qwerty-dvorak/crashguard-iot/README.md

# CrashGuard: motorcycle crash detection and IoT alerts

The complete, self-contained research artifact is in [paper/](paper/).

- [**Read the research paper (PDF)**](paper/main_manuscript.pdf)
- [**LaTeX manuscript**](paper/main_manuscript.tex) and [references](paper/references.bib)
- [ESP32 firmware and circuit](paper/wokwi/)
- [Simulation and evaluation scripts](paper/analysis/)
- [Experimental results and logs](paper/results/)
- [Dataset provenance and source attribution](paper/data/README.md)

### Repository Manuscripts
- **`paper/main_manuscript.tex` (and `.pdf`)**: The **primary, complete research paper** containing the full rigid-body kinematic simulation, Boubezoul et al. (2013) baseline comparison, paired McNemar statistical hypothesis tests, parametric sensitivity analysis, and virtual firmware defect discovery.
- **`review3/review3_report.tex` (and `.pdf`)**: Milestone report submitted for Review 3 (archived).
- **`legacy_v1_report.tex` (and `.pdf`)**: Original project report draft (archived).

## Reproduce the paper

```sh
git clone https://github.com/qwerty-dvorak/crashguard-iot.git
cd crashguard-iot/paper
python3 -m pip install -r analysis/requirements.txt
sh reproduce.sh
```

A C++17 compiler and LaTeX installation with latexmk are required. The `paper/` directory contains all project inputs needed by the build; its pipeline verifies and extracts the bundled public PTW supplement, generates both simulated motion datasets, runs the firmware scenarios, and compiles the PDF. See [paper/README.md](paper/README.md) for details.

The paper evaluates 945 simulated events, 14 firmware scenarios, 39 DC interface combinations, nine battery-discharge cases, and public motorcycle signal gates. The source code and experimental records distinguish detector performance, local warning behaviour, and the simulated event-service boundary.
