qwerty-dvorak/crashguard-iot/review3/Assessment-6 D2 .md

**School of Computer Science and Engineering (SCOPE)**

**Course code and Name: BCSE312P - Programming for IoT Boards Lab**

**Class Number:  VL2026270103137**

**Name of the Faculty: Syamasudha Veeragandham 22727**

# **Date: 4/09/2026 \[11:40 AM to 1:20 PM\]  	Slot: L29+L30       **  

# **Assessment-6**  
**Maximum Marks: 10**

# **Note: Include the suggestions given in the lab 5 also.**  

# **Problem Statement **–IoT Integration, Testing & Performance Evaluation

**Objective:** Validate the developed prototype under different operating conditions and demonstrate its IoT capabilities.

### Students should complete:

1. **Test Cases** 

   - Minimum **5 test cases**. 

   - Include normal, boundary and abnormal conditions. 

2. **Test Results** 

   - Record actual system output. 

   - Compare expected and actual results. 

   - Provide screenshots/logs wherever appropriate. 

3. **Performance Comparison** 

   - Compare **baseline vs proposed method**. 

   - Select suitable metrics: 

     - Accuracy 

     - Response time 

     - Detection rate 

     - False-positive rate 

     - Energy consumption 

     - Network latency 

     - Resource utilization 

     - Prediction accuracy 

4. **IoT Communication Demonstration**

   - Demonstrate communication between: 

**Sensor → IoT Controller → Network → Cloud/Server → User**

   - Suitable technologies: 

     - MQTT 

     - HTTP 

     - Wi-Fi 

     - Firebase 

     - ThingSpeak 

     - Blynk 

     - Node-RED 

5. **Dashboard / User Interface** 

   - Display real-time sensor values. 

   - Show device/actuator status. 

   - Display alerts. 

   - Show graphs or historical data where applicable. 

6. **Fault-Handling Mechanism** 

   - Demonstrate at least **2 fault conditions**. 

   - Examples: 

     - Sensor failure 

     - Invalid sensor value 

     - Network failure 

     - Actuator failure 

     - Power failure 

   - Show how the system detects and handles the fault. 

7. **Expected vs Actual Results** 

   - Prepare a comparison table. 

   - Explain deviations between expected and actual performance. 

8. **Future Enhancement** 

   - Identify at least 3 improvements. 

   - Examples: 

     - AI/ML integration 

     - Edge computing 

     - Mobile application 

     - More sensors 

     - Improved prediction 

     - Security enhancement 

     - Energy optimization 

     - Real-world hardware deployment
