qwerty-dvorak/crashguard-iot/review3/review3_report.pdf

# CrashGuard: IoT Integration, Testing, and Performance Evaluation

### Crash Detection and Rider-Cancellable Emergency Alert System

### Adheesh Garg (23BCT0122) Aastha Gupta (23BCT0082)

### Ayan Gatani (23BCT0059)

### Programming for IoT Boards Lab (BCSE312P)

Class VL2026270103137 | Faculty: Syamasudha Veeragandham (22727)
Assessment 6, Review 3 | 4 September 2026

Abstract

This report evaluates CrashGuard, an ESP32 and MPU-6050 prototype that detects fall-like motorcycle motion, activates a local LED and piezo alarm, gives the rider 15 seconds to cancel, and then attempts a Blynk IoT event. Because physical hardware is unavailable, the evidence combines exact-code native replay, 675 deterministic six-axis events, four public powered-two-wheeler falls, seven public critical manoeuvres, target compilation, and a fresh three-scenario Wokwi virtual-hardware run. Ten normal, boundary, abnormal, and fault-oriented cases are reported. CrashGuard obtains 94.7% simulated event accuracy, 76.0% sensitivity, 100.0% observed specificity, and a 2.31 s median confirmation delay. An acceleration-only comparison is more sensitive (89.3%) but raises false alarms on 55.0% of simulated non-crash events. The report also defines the Blynk event, dashboard mapping, communication chain, fault responses, deviations, and future validation plan. No physical crash accuracy, phone-notification receipt, network latency, or measured battery life is claimed.

## Contents

1 Assessment objective and coverage | 3
2 System under test | 3
3 Evidence, data, and reproducibility | 4
4 Test plan and acceptance criteria | 5
5 Detailed test results | 7
6 Performance comparison | 8
7 IoT communication demonstration | 9
8 Dashboard and user interface | 10
9 Fault handling | 12
10 Expected versus actual results and deviations | 13
11 Resource, energy, and network evaluation | 13
12 Future enhancements | 14
13 Limitations, safety, and conclusion | 14

## 1 Assessment objective and coverage

Assessment 6 requires integration, testing, performance evaluation, IoT communication, a dashboard, fault handling, expected-versus-actual analysis, and future enhancements. Table 1 maps each requirement to the evidence in this report.

Table 1: Assessment requirement coverage.

Requirement | Evidence | Section
At least five tests | Ten normal, boundary, abnormal, and fault-oriented cases | 4–5
Expected versus actual | Acceptance criteria, actual output, status, and de- viation table | 5, 10
Performance comparison | Accuracy, sensitivity, false-positive rate, F1, delay, and resources | 6
IoT communication | Sensor-to-controller-to-network-to-Blynk-to-user chain | 7
Dashboard / UI | Reproducible replay dashboard and Blynk widget specification | 8
Two fault conditions | Sensor/I²C and Wi-Fi/Blynk failure behavior | 9
Future enhancements | Prioritized hardware, communication, security, and model work | 12

The previous review’s suggestions are retained: CrashGuard is treated as one system rather than a sequence of named versions; its thresholds are compared with public motorcycle data; the supplied human-fall paper is audited rather than copied; the firmware and replay share decision logic; and Wokwi and cloud claims are bounded to what was actually tested.

## 2 System under test

### 2.1 Purpose and hardware

CrashGuard is mounted on the motorcycle handlebar. Its MPU-6050 supplies three-axis acceleration and angular rate at 100 Hz. The ESP32 calculates acceleration magnitude, angular-rate magnitude, and tilt relative to the stationary startup gravity vector. GPIO26 drives the warning LED; GPIO25 drives a physical 5 V passive piezo through a transistor; GPIO27 reads the active-low cancel button; and GPIO34 monitors the divided battery voltage. The MPU-6050 is configured for ±16g and ±2000◦/s to reduce immediate saturation under rapid motion [1]. GPIO34 is an ADC1 input and remains usable while Wi-Fi is active [2].

Table 2: Interfaces of the evaluated prototype.

Subsystem | Interface | Evaluated role
MPU-6050 | I²C, GPIO21/22 | Six-axis source at 100 Hz
Local alarm | GPIO26 LED, GPIO25 piezo | Immediate rider-visible/audible warning
Rider input | GPIO27, internal pull- up | Cancels pending cloud alert
Battery sense | GPIO34 through 1:2 divider | Startup voltage observation
Network | ESP32 Wi-Fi station | Phone hotspot or Wokwi-GUEST
Cloud/user | Blynk IoT SSL client | Event timeline and notification attempt

### 2.2 CrashGuard decision sequence

The detector does not equate a single shock with a crash. It first requires one second of ride-like activity and remembers it for five seconds. A candidate then begins when acceleration magnitude A satisfies A ≥ 2.0g or A ≤ 0.35g. Angular motion Ω ≥ 90◦/s must occur within a 750 ms correlation interval, in either order. Finally, tilt must reach 55◦ while 0.70g ≤ A ≤ 1.30g and Ω ≤ 30◦/s continuously for two seconds. A candidate that does not establish final rest within six seconds is rejected.

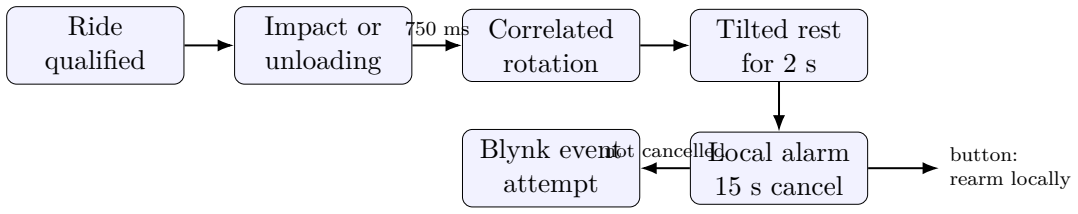
[picture p7: figure]
Ride qualified; Impact or unloading; Correlated rotation; Tilted rest for 2 s; Local alarm 15 s cancel; Blynk event attempt; not cancelled; button:; rearm locally

Figure 1: State sequence exercised by replay and virtual-hardware tests.

## 3 Evidence, data, and reproducibility

### 3.1 Evidence levels

Four evidence levels prevent unlike results from being merged:
1. Exact-code native replay: the same portable C++ detector used by the ESP32 processes complete event streams.
2. Virtual hardware: Wokwi exercises the ESP32 binary, virtual MPU-6050, button, LED, piezo, and serial markers.
3. Target compilation: Arduino compilation verifies ESP32 and Blynk library compatibility and reports static resource use.
4. External audit: public powered-two-wheeler recordings test feature-scale portability but cannot reproduce the complete detector because a reliable mounting-specific gravity reference is absent.
No level represents a physical road test. The Wokwi scenario API can set virtual MPU values and assert serial or pin output, making it useful for repeatable control-flow tests rather than vehicle mechanics [3].

### 3.2 Deterministic and public data

The deterministic dataset contains 675 ten-second events at 100 Hz, or 675,000 six-axis samples. A fixed seed (20260828) generates 75 examples of each class: normal riding, pothole, speed breaker, hard brake, sharp turn, parked tip-over, impact with recovery, low-side crash, and high-side crash. Only the final two classes are labelled positive. The generator uses attitude trajectories, body-frame gravity, linear pulses, derivative-based angular rates, bias, noise, and sensor-range clipping. It is repeatable but remains a model created in the same project as the detector.
The independent powered-two-wheeler archive contributes four controlled falls and seven critical manoeuvres [4, 5]. All four fall windows cross CrashGuard’s acceleration and rotation gates after anti-aliased resampling to 100 Hz; none reaches the stricter 4 g and 200 ◦/s comparison thresholds. This supports scale selection, not a complete external accuracy result.

### 3.3 Reproduction commands on Void Linux

The commands below rebuild the prior dataset, replay results, figures, and report. They do not require Wokwi cloud minutes.

sudo xbps-install -S base-devel python3 python3-pip texlive \
texlive-most texlive-latexmk poppler-utils
cd /path/to/crashguard-iot
python3 -m venv .venv
. .venv/bin/activate
python -m pip install -r analysis/requirements.txt sh data/download_datasets.sh ./analysis/run_all.sh
sha256sum -c data/manifest.sha256
cd review3
python3 make_dashboard.py
latexmk -pdf report.tex

## 4 Test plan and acceptance criteria

The test strategy covers normal operation, threshold boundaries, abnormal but non-crash motion, user cancellation, and unavailable dependencies. A test is Pass only if its observable result meets the predeclared criterion. Partial records a real limitation rather than silently changing the criterion after observing the output.

Table 3: Normal, boundary, abnormal, and fault-oriented test matrix.

ID | Condition | Class | Expected output / acceptance | Actual evidence | Status
TC-01 Normal riding | Normal | No candidate, crash, or alert in
| | | all 75 events | CrashGuard predictions: 0/75 positive | Pass
TC-02 Pothole pulse | Abnormal
| | non-crash | Candidate rejected; LED re-
| | mains low | Replay: 0/75 alerts; Wokwi: CANDIDATE_REJECTED, GPIO26 low | Pass
TC-03 Speed breaker | Boundary non-crash | Reject vertical shock without fall sequence | Replay: 0/75 alerts; acceleration-only method flags 70/75 | Pass
TC-04 High-side crash | Positive | Confirm all clear high-energy ex-
| | amples | Replay: 75/75 detected; fresh Wokwi run reaches local alarm and deadline | Pass
TC-05 Low-side crash | Boundary pos-
itive | Detect every lower-energy crash Replay: 39/75 detected; 36 false negatives | Partial
TC-06 Parked tip-over | Abnormal non-crash | Suppress alert without recent ride activity | Replay: 0/75 alerts; acceleration-only method flags 70/75 | Pass

TC-07 Impact then recov-

ery | Abnormal non-crash | Reject because stable tilted rest is absent | Replay: 0/75 alerts; acceleration-only method flags 74/75 | Pass
TC-08 Rider cancellation User | input
| boundary | Stop alarm and suppress later alert deadline | Fresh Wokwi run: ALERT_CANCELLED; GPIO26 low after 16 s guard | Pass
TC-09 Network/Blynk unavailable | Fault | Preserve detection/local alarm and report skipped event hon- estly | Credential-free target build passes; explicit unavail- able result paths exist; current cloud receipt unmea-
sured | Partial
TC-10 MPU-6050 | un-
available/read
error
Fault | Safe stop at boot or skip corrupt
cycle without false alert

Firmware emits fatal boot or read warning and omits detector update; hardware/Wokwi disconnect not executed

Partial

6

## 5 Detailed test results

### 5.1 Normal and abnormal non-crash conditions

CrashGuard reports no positive decision in any of the 75 normal-riding, 75 pothole, 75 speed-breaker, 75 hard-brake, 75 sharp-turn, 75 parked-tip-over, or 75 impact-recovery events. These 525 results explain the observed 100% specificity. The mechanisms differ: potholes and speed breakers lack the correlated fall sequence; parked tip-overs lack recent ride activity; impact with recovery lacks sustained tilted rest; and hard braking or sharp turns do not satisfy the entire chain.
The acceleration-only comparison highlights why these checks matter. It marks 75/75 potholes, 70/75 speed breakers, 70/75 parked tip-overs, and 74/75 impact-recovery events as crashes. Thus, its 289 false positives are not scattered numerical accidents: they concentrate in plausible riding events that CrashGuard was designed to reject.

### 5.2 Positive and boundary crash conditions

All 75 high-side simulated crashes are detected. Only 39 of 75 low-side cases are detected, making low-side motion the principal boundary failure. The missed examples are lower-energy and sometimes fail to combine the configured acceleration gate, 90 ◦/s rotation, and stable-rest evidence inside the allowed intervals. Lowering a single threshold would recover some cases but would also be unsafe to justify from co-developed synthetic data.

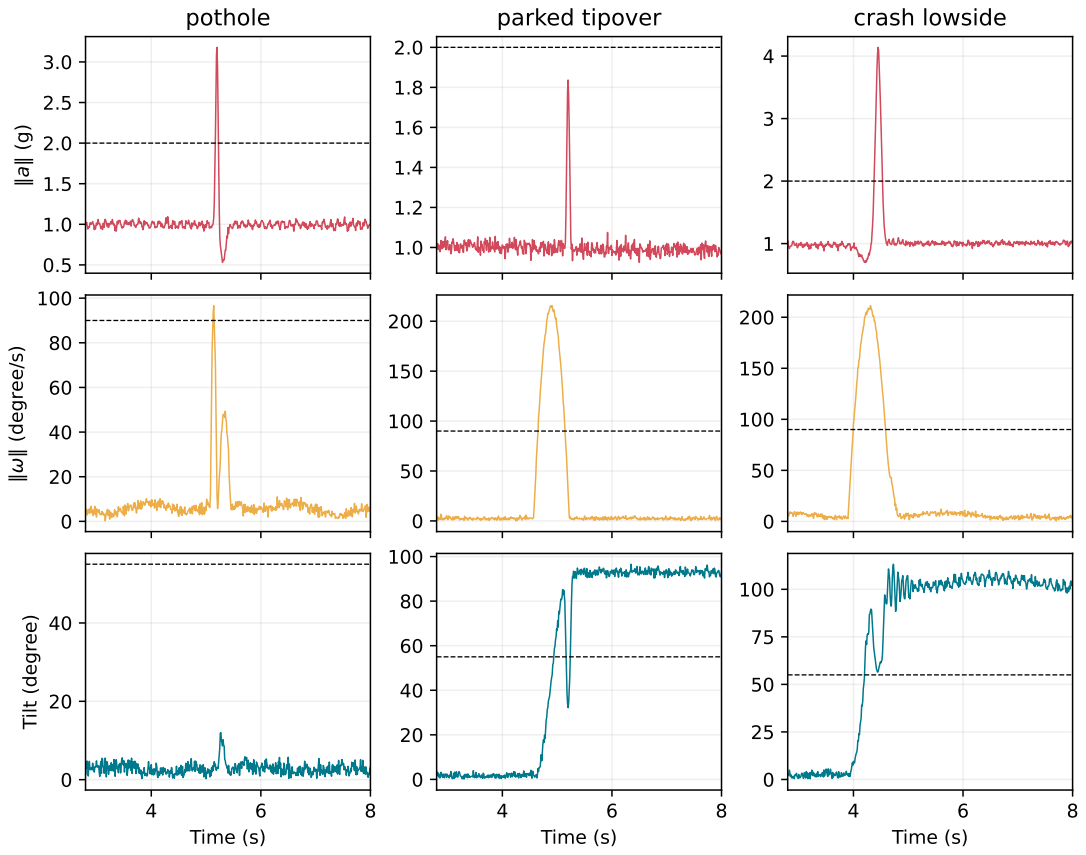
[picture p8: figure]
pothole; parked tipover; crash lowside; gre; Time (s); Tilt (degree)

Figure 2: Representative pothole, parked tip-over, and low-side crash signals. Dashed lines show the relevant CrashGuard gates.

### 5.3 Virtual-hardware output and cancellation

On 4 September 2026, Wokwi CLI 0.26.1 executed the freshly compiled ESP32 binary once against the crash, pothole, and cancellation scenarios. All three completed successfully. The crash run produced the following serial sequence; the numeric candidate values are direct simulator output:

READY sample_hz=100 battery=4.66V
RIDE_ACTIVE
CANDIDATE a=5.00 omega=240.6 tilt=2.3 ROTATION_CONFIRMED
CRASH_CONFIRMED countdown=15s
STATE COUNTDOWN
ALERT_DUE
BLYNK_EVENT_SKIPPED reason=not_configured

The pothole run produced CANDIDATE_REJECTED and verified GPIO26 low. For the cancellation case, the button is pressed after CRASH_CONFIRMED; the observed marker is ALERT_CANCELLED, GPIO26 returns low, remains low after a 16 s guard, and no deadline marker is accepted. The test used no Blynk device credential, so BLYNK_EVENT_SKIPPED reason=not_configured is the expected and observed offline handoff, not a cloud-delivery claim.

## 6 Performance comparison

For positive events, sensitivity is T P/(T P+F N). For negative events, specificity is T N/(T N+ F P) and false-positive rate is F P/(T N+F P). Accuracy is (T P +T N)/N. F1 is the harmonic mean of precision and sensitivity. Wilson intervals are reported because even a zero observed false-positive count does not establish a zero population rate [6].

Table 4: Acceleration-only comparison versus CrashGuard on 675 generated events.

Metric | Acceleration only | CrashGuard | Difference
Accuracy | 54.8% | 94.7% +39.9 points
Sensitivity / detection rate | 89.3% | 76.0% | -13.3 points
Specificity | 45.0% | 100.0% +55.0 points
False-positive rate | 55.0% | 0.0% | -55.0 points
Precision | 31.7% | 100.0% +68.3 points
F1 score | 0.468 | 0.864 | +0.396
Median confirmation delay | 0 ms | 2310 ms | +2310 ms

Acceleration-only comparisonStrict ordered-threshold comparison | CrashGuard

0.0

0.2

0.4

0.6

0.8

1.0

Event-level proportion

Sensitivity
Specificity

Figure 3: Sensitivity and specificity with Wilson 95% intervals. The third bar group is a strict ordered-threshold comparison, not another CrashGuard release. Intervals describe the simulated event counts only.

CrashGuard deliberately trades immediate response and some low-side sensitivity for a large reduction in nuisance alerts. Its median 2.31 s confirmation time is dominated by the required two-second final-rest hold. The Blynk attempt occurs after the additional 15 s cancellation interval, so the median candidate-to-cloud-attempt time is approximately 17.31 s before network delay. This is appropriate for avoiding unwanted emergency alerts, but it is too slow to claim pre-impact detection.
The observed confusion matrices are (T P, T N, F P, F N) = (134, 236, 289, 16) for the acceleration-only method and (114, 525, 0, 36) for CrashGuard. CrashGuard’s sensitivity 95% interval is [68.6%, 82.1%]. Its specificity lower Wilson bound is 99.3%, even though the observed value is 100%. The result remains synthetic and does not estimate false alerts per riding hour or kilometre.

### 6.1 Comparison with the supplied base paper

The supplied base paper reports a shin-mounted LSM6DSM at 50 Hz, 3.4 s windows, a balanced CNN-transformer with focal loss, and human-fall test sensitivity of 90.5%, specificity of 94.5%, and accuracy of 93.1% [7]. CrashGuard uses a handlebar MPU-6050 at 100 Hz and a deterministic temporal state machine. Its 94.7% simulated accuracy must not be described as better than the paper’s 93.1%: sensing body, labels, participants, events, splits, and evaluation units differ, and CrashGuard has no physical test set. The transferable lesson is methodological: report sensitivity and specificity separately, preserve temporal context, and match the method to deployment constraints.

## 7 IoT communication demonstration

MPU-6050
six-axis data

ESP32
CrashGuard

Wi-Fi
hotspot

Blynk Cloud
event

Blynk app
user alert

I

2C | SSL | Internet | notification

Figure 4: Required sensor-to-user chain. Solid arrows show the designed path; only the sensor/controller and local-output segments have virtual-hardware execution evidence in this project.

The firmware starts Wi-Fi asynchronously, preserves local detection when the network is absent, and uses Blynk library 1.3.5 with the ESP32 SSL client. At the alert deadline it requests a cloud connection and calls Blynk.logEvent("crash_confirmed", description). Blynk requires the same event code in the device template; the event settings control timeline recording and user notifications [8, 9]. The code prints BLYNK_EVENT_SUBMITTED only when the library reports an authenticated connection. Since logEvent exposes no delivery receipt, that marker is not treated as proof of cloud or phone receipt.
Wokwi provides the open Wokwi-GUEST network on channel 6 and Internet access for an ESP32 simulation [10]. A dedicated test-device token can exercise the same production code path. The current run deliberately used no Blynk test-device credential: it validates the offline handoff without sending a real event. No real credential appears in source or in this document.

Table 5: Communication-stage verification status.

Stage | Status | Evidence
Sensor → controller | Verified virtually | MPU values drive the exact ESP32 detector path
Controller → alarm | Verified virtually | LED/piezo activation and button cancellation
Controller → Wi-Fi | Compile-verified | Credential-free and Blynk-enabled builds succeed
Wi-Fi → Blynk | Not measured | Opt-in scenario exists; no current authenticated run
Blynk → user | Not measured | Requires configured event, notification settings, and a real recipient

## 8 Dashboard and user interface

Figure 5 is a reproducible dashboard rendered from the low-side exemplar in the deterministic dataset. It displays acceleration, angular rate, tilt, detector status, local alarm state, countdown, and cloud test status. It is a replay UI, not a screenshot of Blynk Cloud.

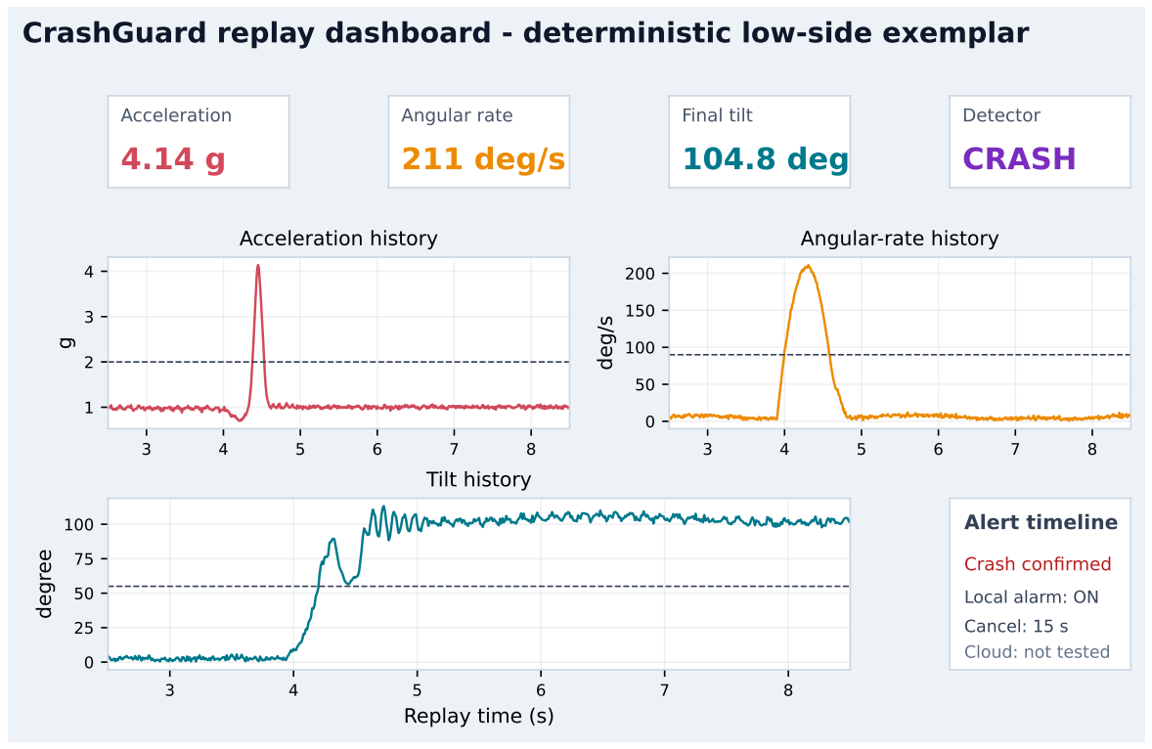
[picture p9: figure]
Acceleration 4.14 g; Angular rate 211 deg/s; Final tilt 104.8 deg; Detector CRASH; Acceleration history; deg/s; Angular-rate history; Replay time (s); degree; Tilt history; Alert timeline; Crash confirmed; Local alarm: ON; Cancel: 15 s; Cloud: not tested

CrashGuard replay dashboard - deterministic low-side exemplar

Figure 5: Replay dashboard generated directly from deterministic six-axis data.

For a Blynk dashboard, datastreams should use virtual pins rather than physical GPIO identifiers. Blynk defines datastreams as time-stamped channels and binds dashboard widgets to them [8, 11]. Telemetry should be published on a controlled timer rather than every 100 Hz detector iteration, which would spam the service. Table 6 defines the intended one-hertz dashboard mapping.

Table 6: Blynk template and dashboard mapping.

Pin | Datastream | Type/range | Widget | Update policy
V0 | Acceleration | magni-
| tude | Double, 0–16 g | Gauge + chart | 1 Hz
V1 | Angular-rate | magni-
| tude | Double, 0–2000 ◦/s | Gauge + chart | 1 Hz
V2 | Tilt | Double, 0–180 ◦ | Gauge + chart | 1 Hz
V3 | Detector-state code | Integer, 0–4 | Label / status | On change
V4 | Battery voltage | Double, 0–5 V | Gauge | Every 60 s
Event | crash_confirmed | Critical event | Timeline + notifica- tion | Once per uncancelled incident

The released firmware currently implements the event path, not continuous V0 through V4 publication. Therefore, the Blynk telemetry dashboard is a precise configuration and next implementation step, while the replay dashboard is the only dashboard with actual values in this report.

## 9 Fault handling

### 9.1 Fault 1: sensor unavailable or read failure

At startup, the ESP32 probes I²C address 0x68. A failed probe prints FATAL_MPU6050_ NOT_FOUND and enters a safe stop, so uninitialized data cannot generate a crash event. During operation, a 14-byte burst-read failure prints WARN_MPU6050_READ_FAILED, returns from the loop iteration, and does not update the state machine. Stationary calibration also rejects gravity outside 0.85–1.15 g or gyro RMS above 5 ◦/s and retries instead of accepting a bad reference.
This is fail-silent detection: it prevents fabricated events but temporarily loses coverage. The source path and target compilation are verified; physical wire removal and current-source Wokwi disconnect injection were not executed. The correct enhancement is a latched sensorhealth state, retry counter, visible fault LED pattern, and controlled bus reinitialization.

### 9.2 Fault 2: Wi-Fi or Blynk unavailable

Network failure cannot block the initial crash decision, local alarm, or cancel button. At the deadline, the firmware distinguishes four outcomes: event submitted, Blynk not configured, Wi-Fi unavailable, and cloud unavailable. Unavailable outcomes produce an explicit serial marker and never claim that a notification was sent. The local alarm remains active until acknowledged.
The credential-free build is current compile evidence, and the fresh Wokwi run demonstrated local alarm behavior without cloud credentials. A real Wi-Fi-drop/Blynk-recovery run remains outstanding. The main functional gap is that the current event attempt is one-shot; a production design should queue the incident in nonvolatile storage and retry with capped exponential backoff.

Table 7: Fault detection, safe response, and residual risk.

Fault | Detection | Current response | Residual risk
MPU absent at boot | I
| 2C probe fails | Fatal marker; safe stop | No automatic field re-
| | | covery
MPU read failure | Burst length/status in- valid | Warning; skip detector update | Detection gap; repeated logs
Bad | calibration
motion
Gravity/gyro | bounds
| fail | Retry calibration | Device remains unavail- able until still
Wi-Fi unavailable | ESP32 link state not connected | Explicit skipped marker; local alarm continues | Incident not queued for retry
Blynk unavailable | Authenticated connect times out
Explicit | cloud-
| | unavailable marker | User receives no remote alert

Power and actuator faults are not yet detected. The ADC voltage is printed at startup but no calibrated low-battery cutoff exists, and the ESP32 cannot confirm that a piezo actually produced sound without current or acoustic feedback. These are documented gaps rather than passed tests.

## 10 Expected versus actual results and deviations

Table 8: Expectation, observed result, and interpretation.

Expectation | Actual result | Deviation | Explanation / decision

Reject ordinary and abnormal non-crashes

0/525 CrashGuard false
positives

Meets finite simulation set

| | | Temporal | correlation,
ride qualification, and
final rest reject isolated
| | | motion
Detect high-energy crashes | 75/75 high-side detected | Meets generated set | Strong | im-
| | | pact/rotation/rest
pattern crosses all gates
Detect | lower-energy
crashes
39/75 low-side detected | 36 false negatives | Fixed gates and timing
miss weaker profiles; do
not retune on the same
| | | generator
Alert immediately after confirmation | Local alarm immediate; cloud attempt after 15 s
Intentional 15 s delay | Cancellation reduces un-
wanted remote alerts
Deliver Blynk alert to user | Event | path | compile-
verified; | receipt | not
| measured
Incomplete | end-to-
| | end evidence

Requires test device,
| | | network, | configured
| | | event, and phone
Operate for about 13 h | Only a power-budget esti- mate exists
Runtime unmeasured | Converter efficiency and
real duty cycle need
| | | hardware logging
Recover | from | sen-
sor/network faults | Safe skip/stop exists; auto- matic retry limited
Partial | Add health state, persis-
tence, retry, and diag-
| | | nostics

The largest favorable deviation relative to the acceleration-only method is false-positive control: 289 simulated false alarms are removed. The cost is 20 additional false negatives (36 instead of 16) and a 2.31 s median confirmation delay. In a safety system this is not automatically a good trade; it defines a candidate operating point that must be evaluated on target-domain physical data before selection.

## 11 Resource, energy, and network evaluation

The credential-free ESP32 build uses 392,955 bytes of flash (29%) and 29,808 bytes of static RAM (9%). The Blynk SSL build uses 1,040,295 bytes (79%) and 49,124 bytes (14%). Both fit the selected target, but the SSL certificate and network stack leave much less flash margin. These figures do not include worst-case stack/heap fragmentation or long-duration behavior. At an estimated average 5 V load of 120 mA, the load power is 0.60 W. Assuming a 3.7 V, 2600 mAh cell, 90% usable capacity, and 90% boost efficiency gives

Icell ≈

5(0.120)
3.7(0.90) = 0.180 A, t ≈

2.6(0.90)
0.180
= 13.0 h. | (1)

This is a sizing estimate, not measured energy consumption. Network latency is also not reported: compiler success and a simulated alert deadline provide no round-trip timing to Blynk. Physical evaluation should record detection time, Wi-Fi association, TLS connection, Blynk timeline arrival, and phone notification arrival using synchronized clocks.

## 12 Future enhancements

The following work is prioritized by safety evidence rather than novelty:
1. Physical target-domain dataset. Instrument a rigid handlebar mount; bench-check scale and orientation; collect ordinary riding over braking, turns, potholes, speed breakers, weather, payload, and mount variations; then collect unmanned soft-containment tip/drop trials. Freeze thresholds before a held-out route and report false alerts per hour and kilometre.
2. Reliable event delivery. Store an uncancelled incident in nonvolatile memory, attach monotonic time and delivery state, retry with capped backoff, clear only after a verifiable server acknowledgement, and prevent event storms. Blynk documents a per-device event limit, so one event per incident and rate control are required [9].
3. Complete dashboard telemetry. Publish V0–V4 at controlled rates, enable history where appropriate, add connection-age and sensor- health indicators, and validate web/mobile widgets with a dedicated test device.
4. Fault diagnostics. Add a sensor retry state, watchdog, low-battery threshold with hysteresis, brownout log, alarm-current feedback, and visible degraded-mode indication.
5. Location integration. Add GNSS or a companion-phone protocol. A hotspot alone does not expose phone GPS; coordinates must never be fabricated.
6. Model improvement after data collection. Compare the frozen state machine with small trees or quantized temporal models using subject/route/vehicle-separated evaluation. The supplied transformer’s 50 Hz human-shin result is architectural guidance, not training data for this motorcycle problem.
7. Security and maintenance. Keep device tokens outside source, use TLS, rotate compromised tokens, restrict Blynk device privileges, record firmware identity, and define a signed update and rollback plan.

## 13 Limitations, safety, and conclusion

The generated signals omit frame flexibility, mount slip, engine harmonics, temperature drift, varied impact points, rider separation, traffic, and radio conditions. The public archive contains only four controlled falls. The generator and thresholds were co-developed, Wokwi does not simulate vehicle mechanics or the power circuit, the Blynk user path lacks an authenticated current run, and no energy or latency measurement exists. The prototype is not a certified automotive, medical, or emergency device. Deliberate public-road crash tests would be unsafe.
Within these limits, CrashGuard demonstrates an integrated and repeatable sensor-tolocal-alarm system with rider cancellation and a compile-verified Blynk event path. It passes seven of ten listed cases completely and exposes the remaining gaps: low-side sensitivity, end-to-end cloud proof, and physical fault injection. Compared with acceleration alone, it improves simulated accuracy from 54.8% to 94.7% and removes 289 false positives, while reducing sensitivity and adding confirmation delay. The next defensible milestone is not a stronger accuracy claim; it is a physical holdout study plus an authenticated, timestamped Blynk delivery test.

## References

[1] TDK InvenSense, MPU-6000 and MPU-6050 Product Specification, Revision 3.4, 2013. [Online]. Available: https://invensense.tdk.com/wp-content/uploads/2015/02/MPU-6000-Dat asheet.pdf (https://invensense.tdk.com/wp-content/uploads/2015/02/MPU-6000-Datasheet.pdf)
[2] Espressif Systems, ESP32 Series Datasheet, 2025. [Online]. Available: https://www.espressif.com/sites/default/files/documentation/esp32_datasheet_en.pdf (https://www.espressif.com/sites/default/files/documentation/esp32_datasheet_en.pdf)
[3] Wokwi, “Automation scenarios,” 2026, accessed 4 September 2026. [Online]. Available: https://docs.wokwi.com/wokwi-ci/automation-scenarios
[4] A. Boubezoul, S. Espié, B. Larnaudie, and S. Bouaziz, “A simple fall detection algorithm for powered two wheelers,” Control Engineering Practice, vol. 21, no. 3, pp. 286–297, 2013.
[5] A. Boubezoul, F. Dufour, S. Bouaziz, B. Larnaudie, and S. Espié, “Dataset on powered two wheelers fall and critical events detection,” Data in Brief, vol. 23, p. 103828, 2019.
[6] E. B. Wilson, “Probable inference, the law of succession, and statistical inference,” Journal of the American Statistical Association, vol. 22, no. 158, pp. 209–212, 1927.
[7] J. Tian, S. Xu, P. Gerstoft, M. Sarkar, A. A. Moore, P. Mercier, and C. Paolini, “A multi-head attention transformer model for wearable in situ fall detection,” IEEE Access, vol. 14, pp. 85 242–85 262, 2026.
[8] Blynk, “Device template documentation,” 2026, accessed 4 September 2026. [Online]. Available: https://docs.blynk.io/en/concepts/device-template
[9] ——, “Events tutorial and firmware api,” 2026, accessed 4 September 2026. [Online]. Available: https://docs.blynk.io/en/getting-started/events-tutorial
[10] Wokwi, “ESP32 WiFi Networking,” 2026, accessed 4 September 2026. [Online]. Available: https://docs.wokwi.com/guides/esp32-wifi
[11] Blynk, “Send data from hardware to blynk,” 2026, accessed 4 September 2026. [Online]. Available: https://docs.blynk.io/en/getting-started/how-to-display-any-sensor-data-in-bly nk-app (https://docs.blynk.io/en/getting-started/how-to-display-any-sensor-data-in-blynk-app)
