qwerty-dvorak/crashguard-iot/paper/figures/external_ptw_features.pdf

01234

## Peak acceleration (g)

CrashGuard threshold
Strict comparison

Fall ona slippery straight road section Fall with leaningof the motorcycle

Fall in the roundabout
Fall in
a curve

AccelerationOn Curve

AccelerationOn Straight Line Fall Like manoeuvre1

Fall Like manoeuvre2

Fall Like manoeuvre3

Harsh breakingOn Straight Line

Much degraded track

0

50

100

150

200

## Peak angular rate (degree/s)
