qwerty-dvorak/crashguard-iot/paper/figures/confusion_delay.pdf

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

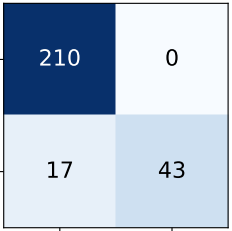
[picture p24: figure]
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
