qwerty-dvorak/crashguard-iot/paper/results/fresh_table.tex

\begin{tabular}{@{}lrrrrrrrr@{}}\toprule Detector & TP & TN & FP & FN & Acc. & Sens. & Spec. & F1\\\midrule
Acceleration-only & 52 & 102 & 108 & 8 & 57.0 & 86.7 & 48.6 & 0.473 \\
Strict ordered-threshold & 12 & 210 & 0 & 48 & 82.2 & 20.0 & 100.0 & 0.333 \\
Boubezoul et al. (2013) & 52 & 176 & 34 & 8 & 84.4 & 86.7 & 83.8 & 0.712 \\
CrashGuard & 43 & 210 & 0 & 17 & 93.7 & 71.7 & 100.0 & 0.835 \\
\bottomrule\end{tabular}
