qwerty-dvorak/crashguard-iot/paper/results/generated_macros.tex

% Generated by analysis/evaluate.py. Do not edit by hand.
\newcommand{\SimulationSeed}{20260828}
\newcommand{\SimulationEvents}{675}
\newcommand{\SimulationSamples}{675,000}
\newcommand{\PositiveEvents}{150}
\newcommand{\NegativeEvents}{525}
\newcommand{\CrashGuardSensitivity}{76.0\%}
\newcommand{\CrashGuardSpecificity}{100.0\%}
\newcommand{\CrashGuardFOne}{0.864}
\newcommand{\CrashGuardTP}{114}
\newcommand{\CrashGuardTN}{525}
\newcommand{\CrashGuardFP}{0}
\newcommand{\CrashGuardFN}{36}
\newcommand{\CrashGuardSensitivityLow}{68.6\%}
\newcommand{\CrashGuardSensitivityHigh}{82.1\%}
\newcommand{\CrashGuardSpecificityLow}{99.3\%}
\newcommand{\CrashGuardConfirmationDelayMs}{2315}
\newcommand{\CrashGuardImpactThreshold}{2.00}
\newcommand{\CrashGuardLowImpactThreshold}{0.35}
\newcommand{\CrashGuardRotationThreshold}{90}
\newcommand{\CrashGuardTiltThreshold}{55}
\newcommand{\CrashGuardRestHoldMs}{2000}
\newcommand{\CrashGuardCorrelationMs}{750}
\newcommand{\CrashGuardRideQualificationMs}{1000}
\newcommand{\CrashGuardRideMemoryMs}{5000}
\newcommand{\BaselineSensitivity}{89.3\%}
\newcommand{\BaselineSpecificity}{45.0\%}
\newcommand{\BaselineFOne}{0.468}
\newcommand{\OrderedSensitivity}{26.0\%}
\newcommand{\OrderedSpecificity}{100.0\%}
\newcommand{\OrderedFOne}{0.413}
\newcommand{\OrderedConfirmationDelayMs}{3120}
\newcommand{\BoubezoulSensitivity}{90.0\%}
\newcommand{\BoubezoulSpecificity}{83.0\%}
\newcommand{\BoubezoulFOne}{0.722}
\newcommand{\BoubezoulTP}{135}
\newcommand{\BoubezoulTN}{436}
\newcommand{\BoubezoulFP}{89}
\newcommand{\BoubezoulFN}{15}
\newcommand{\BoubezoulConfirmationDelayMs}{2280}
\newcommand{\McNemarBoubezoulStat}{40.81}
\newcommand{\McNemarBoubezoulPValue}{1.6785e-10}
\newcommand{\McNemarOrderedStat}{73.01}
\newcommand{\McNemarOrderedPValue}{0.0000e+00}
\newcommand{\McNemarBaselineStat}{232.44}
\newcommand{\McNemarBaselinePValue}{0.0000e+00}
\newcommand{\ExternalFallCount}{4}
\newcommand{\ExternalManoeuvreCount}{7}
\newcommand{\ExternalFourGPass}{0}
\newcommand{\ExternalTwoHundredPass}{0}
\newcommand{\ExternalCrashGuardImpactPass}{4}
\newcommand{\ExternalCrashGuardRotationPass}{4}
