qwerty-dvorak/crashguard-iot/paper/results/energy.csv

load_ma | efficiency | runtime_h
90 | 0.8 | 14.976111
90 | 0.9 | 16.848056
90 | 0.95 | 17.784167
120 | 0.8 | 11.232222
120 | 0.9 | 12.636111
120 | 0.95 | 13.338056
180 | 0.8 | 7.488056
180 | 0.9 | 8.424167
180 | 0.95 | 8.892222
