qwerty-dvorak/crashguard-iot/paper/results/event_results.csv

event_id | label | scenario | baseline_prediction | ordered_prediction | boubezoul_prediction | crashguard_prediction | baseline_detection_ms | ordered_detection_ms | boubezoul_detection_ms | crashguard_detection_ms | baseline_confirmation_delay_ms | ordered_confirmation_delay_ms | boubezoul_confirmation_delay_ms | crashguard_confirmation_delay_ms
SIM-0000 | 0 | normal_riding | 0 | 0 | 0 | 0 | -1 | -1 | -1 | -1 | -1 | -1 | -1 | -1
SIM-0001 | 0 | normal_riding | 0 | 0 | 0 | 0 | -1 | -1 | -1 | -1 | -1 | -1 | -1 | -1
SIM-0002 | 0 | normal_riding | 0 | 0 | 0 | 0 | -1 | -1 | -1 | -1 | -1 | -1 | -1 | -1
SIM-0003 | 0 | normal_riding | 0 | 0 | 0 | 0 | -1 | -1 | -1 | -1 | -1 | -1 | -1 | -1
SIM-0004 | 0 | normal_riding | 0 | 0 | 0 | 0 | -1 | -1 | -1 | -1 | -1 | -1 | -1 | -1
SIM-0005 | 0 | normal_riding | 0 | 0 | 0 | 0 | -1 | -1 | -1 | -1 | -1 | -1 | -1 | -1
SIM-0006 | 0 | normal_riding | 0 | 0 | 0 | 0 | -1 | -1 | -1 | -1 | -1 | -1 | -1 | -1
SIM-0007 | 0 | normal_riding | 0 | 0 | 0 | 0 | -1 | -1 | -1 | -1 | -1 | -1 | -1 | -1
SIM-0008 | 0 | normal_riding | 0 | 0 | 0 | 0 | -1 | -1 | -1 | -1 | -1 | -1 | -1 | -1
SIM-0009 | 0 | normal_riding | 0 | 0 | 0 | 0 | -1 | -1 | -1 | -1 | -1 | -1 | -1 | -1
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
