qwerty-dvorak/crashguard-iot/paper/results/external_ptw_features.csv

recording | label | samples_100hz | peak_acceleration_g | minimum_acceleration_g | peak_angular_rate_dps | passes_strict_acceleration_4g | passes_crashguard_acceleration | passes_strict_rotation_200dps | passes_crashguard_rotation
Fall on a slippery straight road section | 1 | 300 | 1.1687683401687385 | 0.013320606880084107 | 179.35344363618722 | 0 | 1 | 0 | 1
Fall with leaning of the motorcycle | 1 | 300 | 1.8780329774948024 | 0.04090969156086132 | 144.06995348963864 | 0 | 1 | 0 | 1
Fall in the roundabout | 1 | 300 | 1.689564657131486 | 0.011261449746065952 | 150.48782486513088 | 0 | 1 | 0 | 1
Fall in a curve | 1 | 300 | 1.436022616870969 | 0.13044204050633854 | 151.6081563278681 | 0 | 1 | 0 | 1
Acceleration On Curve | 0 | 4794 | 1.5366238837913289 | 0.013821435758300098 | 103.73624188210344 | 0 | 1 | 0 | 1
Acceleration On Straight Line | 0 | 13831 | 1.5687129697018347 | 0.015674545950221393 | 118.98094686849127 | 0 | 1 | 0 | 1
Fall Like manoeuvre 1 | 0 | 13248 | 1.7439264186018635 | 0.0174514235205952 | 61.2172399201275 | 0 | 1 | 0 | 0
Fall Like manoeuvre 2 | 0 | 14893 | 1.5169889555085558 | 0.01674670206649165 | 51.05790657085563 | 0 | 1 | 0 | 0
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
