qwerty-dvorak/crashguard-iot/paper/results/fresh_events.csv

event_id | label | scenario | baseline_prediction | ordered_prediction | boubezoul_prediction | crashguard_prediction | baseline_detection_ms | ordered_detection_ms | boubezoul_detection_ms | crashguard_detection_ms | baseline_confirmation_delay_ms | ordered_confirmation_delay_ms | boubezoul_confirmation_delay_ms | crashguard_confirmation_delay_ms
FRESH-00-00 | 0 | normal_riding | 0 | 0 | 0 | 0 | -1 | -1 | -1 | -1 | -1 | -1 | -1 | -1
FRESH-00-01 | 0 | normal_riding | 0 | 0 | 0 | 0 | -1 | -1 | -1 | -1 | -1 | -1 | -1 | -1
FRESH-00-02 | 0 | normal_riding | 0 | 0 | 0 | 0 | -1 | -1 | -1 | -1 | -1 | -1 | -1 | -1
FRESH-00-03 | 0 | normal_riding | 0 | 0 | 0 | 0 | -1 | -1 | -1 | -1 | -1 | -1 | -1 | -1
FRESH-00-04 | 0 | normal_riding | 0 | 0 | 0 | 0 | -1 | -1 | -1 | -1 | -1 | -1 | -1 | -1
FRESH-00-05 | 0 | normal_riding | 0 | 0 | 0 | 0 | -1 | -1 | -1 | -1 | -1 | -1 | -1 | -1
FRESH-00-06 | 0 | normal_riding | 0 | 0 | 0 | 0 | -1 | -1 | -1 | -1 | -1 | -1 | -1 | -1
FRESH-00-07 | 0 | normal_riding | 0 | 0 | 0 | 0 | -1 | -1 | -1 | -1 | -1 | -1 | -1 | -1
FRESH-00-08 | 0 | normal_riding | 0 | 0 | 0 | 0 | -1 | -1 | -1 | -1 | -1 | -1 | -1 | -1
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
