qwerty-dvorak/crashguard-iot/review3/figures/replay_dashboard.pdf

## 4.14 g

## 211 deg/s

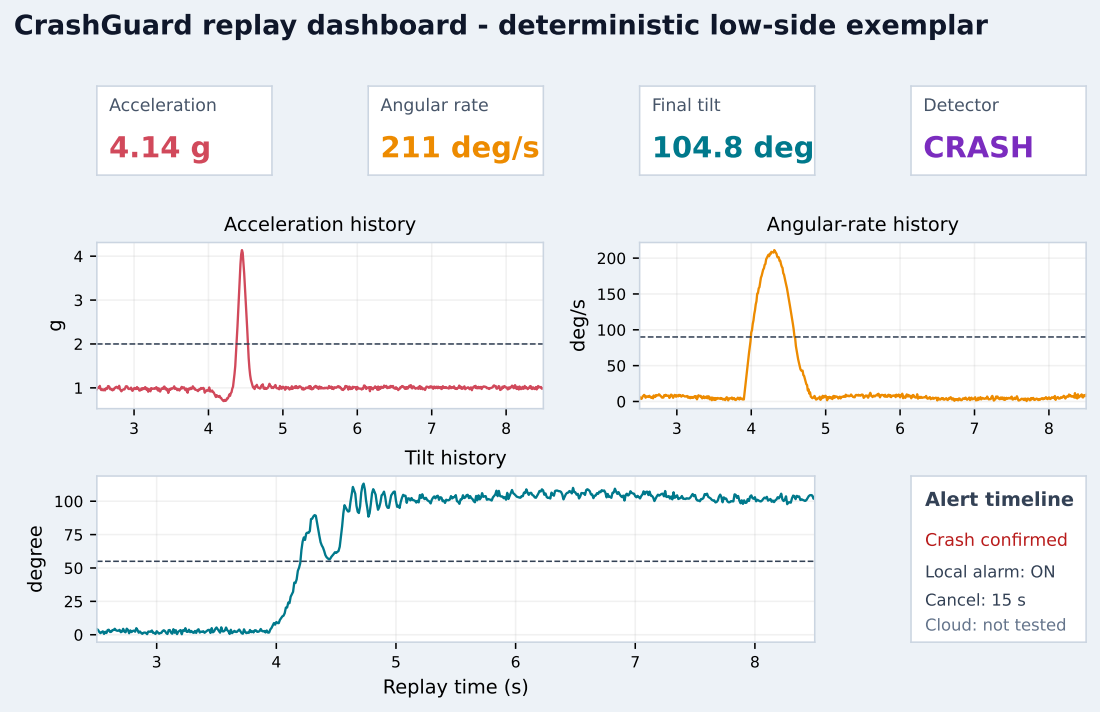
[picture p25: page 1]
Acceleration; Angular rate; Final tilt 104.8 deg; Detector CRASH; Acceleration history; deg/s; Replay time (s); degree; Tilt history; Alert timeline; Crash confirmed

CrashGuard replay dashboard - deterministic low-side exemplar

Angular-rate history

Local alarm: ON
Cancel: 15 s
Cloud: not tested
