qwerty-dvorak/crashguard-iot/paper/overleaf_images/simulated_profiles.pdf

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

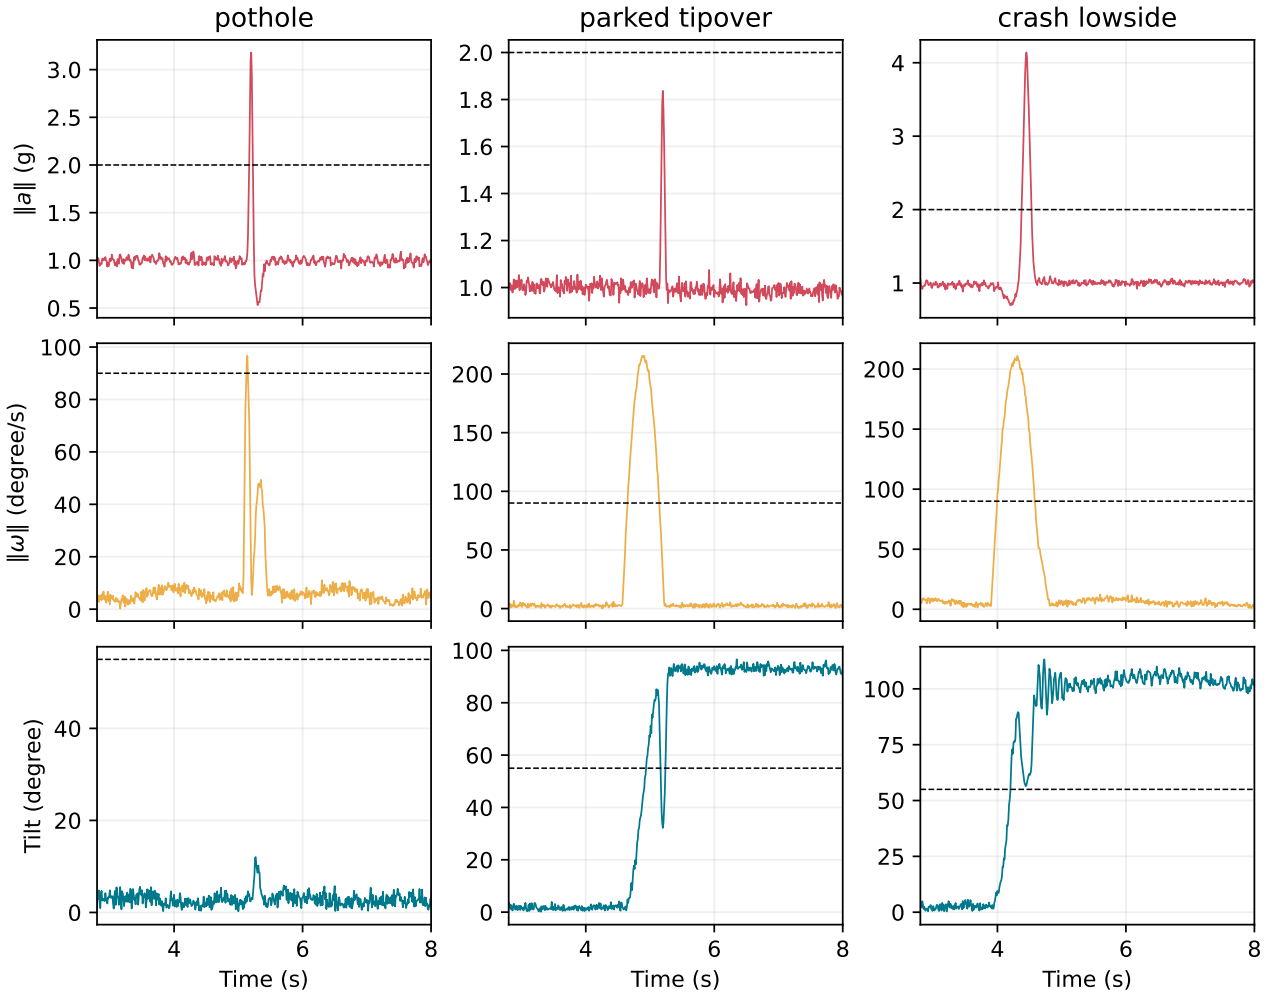
[picture p26: page 1]
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
