qwerty-dvorak/crashguard-iot/paper/figures/simulated_profiles.pdf

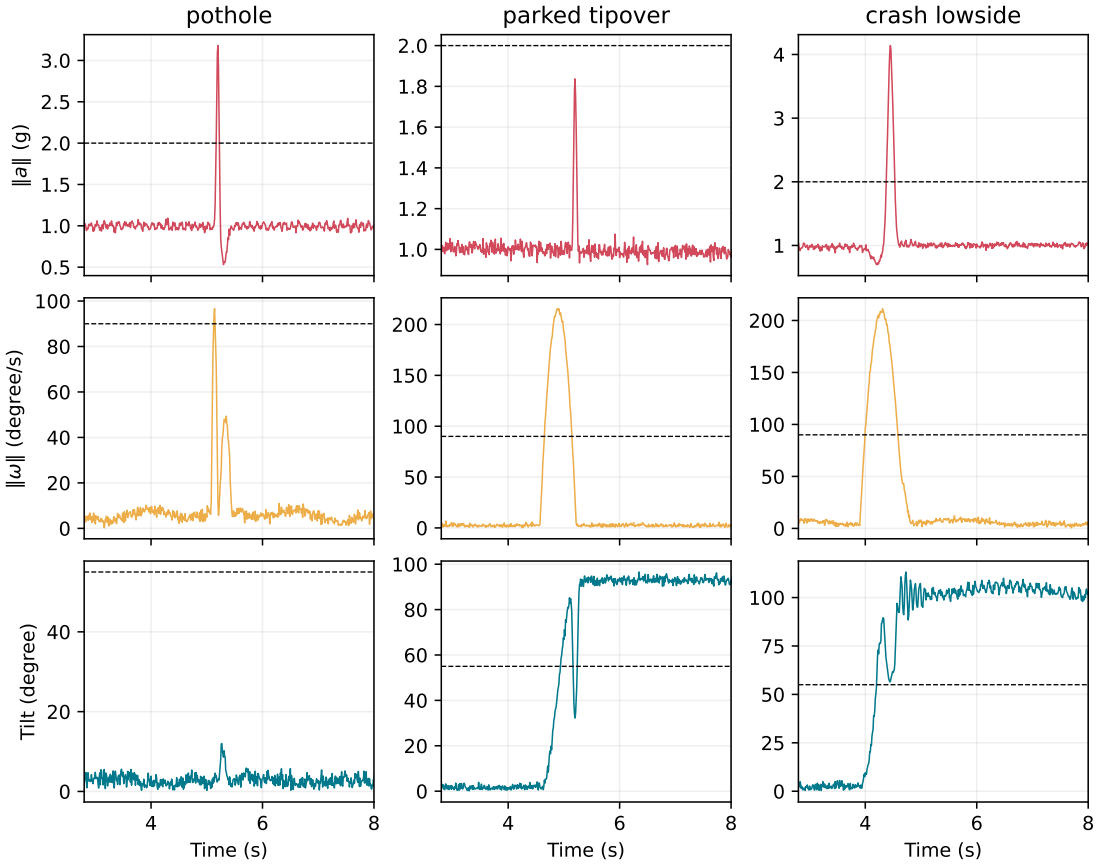
[picture p29: page 1]
pothole; parked tipover; crash lowside; ‖ω‖ (degree/s); Time (s); Tilt (degree)
