qwerty-dvorak/crashguard-iot/figures/simulated_profiles.pdf

pothole; parked tipover; crash lowside; ‖ω‖ (degree/s); Time (s); Tilt (degree)
