qwerty-dvorak/crashguard-iot/paper/analysis/detector_replay.cpp

#include <cmath>
#include <cstdint>
#include <cstdlib>
#include <iomanip>
#include <iostream>
#include <sstream>
#include <string>

#include "../wokwi/crash_detector.h"

namespace {

struct OrderedRuleDetector {
  enum class State { Idle, Rotation, Tilt };
  State state = State::Idle;
  uint32_t impactMs = 0;
  uint32_t tiltStartMs = 0;
  bool detected = false;
  uint32_t detectionMs = 0;

  void update(const crashguard::Sample &sample,
              const crashguard::Features &features) {
    if (detected) return;
    switch (state) {
      case State::Idle:
        if (features.accelerationG >= 4.0f) {
          state = State::Rotation;
          impactMs = sample.timeMs;
        }
        break;
      case State::Rotation:
        if (features.angularRateDps >= 200.0f &&
            sample.timeMs - impactMs <= 500) {
          state = State::Tilt;
        } else if (sample.timeMs - impactMs > 500) {
          state = State::Idle;
        }
        break;
      case State::Tilt: {
        const bool atRest = features.tiltDeg >= 60.0f &&
                            features.accelerationG >= 0.70f &&
                            features.accelerationG <= 1.30f;
        if (atRest) {
          if (tiltStartMs == 0) tiltStartMs = sample.timeMs;
          if (sample.timeMs - tiltStartMs >= 3000) {
            detected = true;
            detectionMs = sample.timeMs;
          }
        } else {
          tiltStartMs = 0;
        }
        if (!detected && sample.timeMs - impactMs > 8000) {
          state = State::Idle;
          tiltStartMs = 0;
        }
        break;
      }
    }
  }
};

struct Boubezoul2013Detector {
  enum class State { Idle, FallInProgress, RestVerification };
  State state = State::Idle;
  uint32_t triggerMs = 0;
  uint32_t restStartMs = 0;
  bool detected = false;
  uint32_t detectionMs = 0;

  void update(const crashguard::Sample &sample,
              const crashguard::Features &features) {
    if (detected) return;
    const float rollRate = std::abs(sample.gxDps);
    const bool isFallInception = (rollRate >= 60.0f) ||
                                 (features.accelerationG >= 2.5f) ||
                                 (features.accelerationG <= 0.40f);

    switch (state) {
      case State::Idle:
        if (isFallInception) {
          state = State::FallInProgress;
          triggerMs = sample.timeMs;
        }
        break;
      case State::FallInProgress:
        if (features.tiltDeg >= 55.0f) {
          state = State::RestVerification;
          restStartMs = sample.timeMs;
        } else if (sample.timeMs - triggerMs > 2000) {
          state = State::Idle;
        }
        break;
      case State::RestVerification: {
        const bool atRest = (features.tiltDeg >= 55.0f) &&
                            (features.accelerationG >= 0.70f) &&
                            (features.accelerationG <= 1.30f) &&
                            (features.angularRateDps <= 30.0f);
        if (atRest) {
          if (sample.timeMs - restStartMs >= 1500) {
            detected = true;
            detectionMs = sample.timeMs;
          }
        } else {
          restStartMs = sample.timeMs;
        }
        if (!detected && sample.timeMs - triggerMs > 6000) {
          state = State::Idle;
        }
        break;
      }
    }
  }
};

struct EventResult {
  std::string id;
  int label = 0;
  std::string scenario;
  bool baseline = false;
  bool ordered = false;
  bool boubezoul = false;
  bool crashguard = false;
  int64_t baselineMs = -1;
  int64_t orderedMs = -1;
  int64_t boubezoulMs = -1;
  int64_t crashguardMs = -1;
  int64_t baselineConfirmationDelayMs = -1;
  int64_t orderedConfirmationDelayMs = -1;
  int64_t boubezoulConfirmationDelayMs = -1;
  int64_t crashguardCandidateMs = -1;
  int64_t crashguardConfirmationDelayMs = -1;
};

void writeResult(const EventResult &result) {
  if (result.id.empty()) return;
  std::cout << result.id << ',' << result.label << ',' << result.scenario << ','
            << static_cast<int>(result.baseline) << ','
            << static_cast<int>(result.ordered) << ','
            << static_cast<int>(result.boubezoul) << ','
            << static_cast<int>(result.crashguard) << ','
            << result.baselineMs << ',' << result.orderedMs << ','
            << result.boubezoulMs << ',' << result.crashguardMs << ','
            << (result.baseline ? 0 : -1) << ','
            << result.orderedConfirmationDelayMs << ','
            << result.boubezoulConfirmationDelayMs << ','
            << result.crashguardConfirmationDelayMs << '\n';
}

bool parseLine(const std::string &line, std::string &eventId, int &label,
               std::string &scenario, crashguard::Sample &sample) {
  std::stringstream stream(line);
  std::string field;
  if (!std::getline(stream, eventId, ',')) return false;
  if (!std::getline(stream, field, ',')) return false;
  label = std::atoi(field.c_str());
  if (!std::getline(stream, scenario, ',')) return false;
  if (!std::getline(stream, field, ',')) return false;
  sample.timeMs = static_cast<uint32_t>(std::strtoul(field.c_str(), nullptr, 10));
  float values[6]{};
  for (float &value : values) {
    if (!std::getline(stream, field, ',')) return false;
    value = std::strtof(field.c_str(), nullptr);
  }
  sample.axG = values[0];
  sample.ayG = values[1];
  sample.azG = values[2];
  sample.gxDps = values[3];
  sample.gyDps = values[4];
  sample.gzDps = values[5];
  return true;
}

}  // namespace

int main() {
  std::ios::sync_with_stdio(false);
  std::cout << "event_id,label,scenario,baseline_prediction,ordered_prediction,"
               "boubezoul_prediction,crashguard_prediction,baseline_detection_ms,"
               "ordered_detection_ms,boubezoul_detection_ms,crashguard_detection_ms,"
               "baseline_confirmation_delay_ms,ordered_confirmation_delay_ms,"
               "boubezoul_confirmation_delay_ms,crashguard_confirmation_delay_ms\n";

  std::string line;
  std::getline(std::cin, line);  // CSV header.
  std::string activeId;
  EventResult result;
  crashguard::Detector detector;
  Boubezoul2013Detector boubezoul;
  OrderedRuleDetector ordered;

  while (std::getline(std::cin, line)) {
    if (line.empty()) continue;
    std::string eventId;
    std::string scenario;
    int label = 0;
    crashguard::Sample sample{};
    if (!parseLine(line, eventId, label, scenario, sample)) {
      std::cerr << "Invalid input row: " << line.substr(0, 120) << '\n';
      return 2;
    }

    if (activeId != eventId) {
      writeResult(result);
      activeId = eventId;
      result = EventResult{};
      result.id = eventId;
      result.label = label;
      result.scenario = scenario;
      detector.reset();
      detector.setReferenceGravity(0.0f, 0.0f, 1.0f);
      boubezoul = Boubezoul2013Detector{};
      ordered = OrderedRuleDetector{};
    }

    const float acceleration = std::sqrt(sample.axG * sample.axG +
                                         sample.ayG * sample.ayG +
                                         sample.azG * sample.azG);
    if (!result.baseline && acceleration >= 2.0f) {
      result.baseline = true;
      result.baselineMs = sample.timeMs;
    }

    const crashguard::Event events = detector.update(sample);
    if (crashguard::hasEvent(events, crashguard::CandidateStarted)) {
      result.crashguardCandidateMs = sample.timeMs;
    }
    if (!result.crashguard &&
        crashguard::hasEvent(events, crashguard::CrashConfirmed)) {
      result.crashguard = true;
      result.crashguardMs = sample.timeMs;
      result.crashguardConfirmationDelayMs =
          result.crashguardMs - result.crashguardCandidateMs;
    }

    const crashguard::Features f = detector.features();

    boubezoul.update(sample, f);
    if (!result.boubezoul && boubezoul.detected) {
      result.boubezoul = true;
      result.boubezoulMs = boubezoul.detectionMs;
      result.boubezoulConfirmationDelayMs =
          result.boubezoulMs - boubezoul.triggerMs;
    }

    ordered.update(sample, f);
    if (!result.ordered && ordered.detected) {
      result.ordered = true;
      result.orderedMs = ordered.detectionMs;
      result.orderedConfirmationDelayMs =
          result.orderedMs - ordered.impactMs;
    }
  }
  writeResult(result);
  return 0;
}
