qwerty-dvorak/crashguard-iot/(commit log)

2026-08-28 Publish CrashGuard research prototype
    [event_results.csv, exemplar_signals.csv, external_ptw_features.csv]
2026-08-28 Pin checksum-verified Arduino CLI in CI
2026-08-28 Unify CrashGuard report and add Blynk Wokwi support
    [event_results.csv, external_ptw_features.csv]
2026-09-11 Publish self-contained CrashGuard paper and reproducible experiments
    [circuit_dc.csv, energy.csv, event_results.csv, exemplar_signals.csv, external_ptw_features.csv, fresh_events.csv, splits.csv]
2026-10-26 Edit manuscript prose for flow and ignore reference PDFs
    Vary sentence structure and transitions without changing any number,
    citation, reference or equation. Ignore rp*.pdf style-reference papers.
